sheemia/STC89C52RC-AutoCar/Document/Gerber_PCB1_2025-12-20_仿真图_(顶层).png

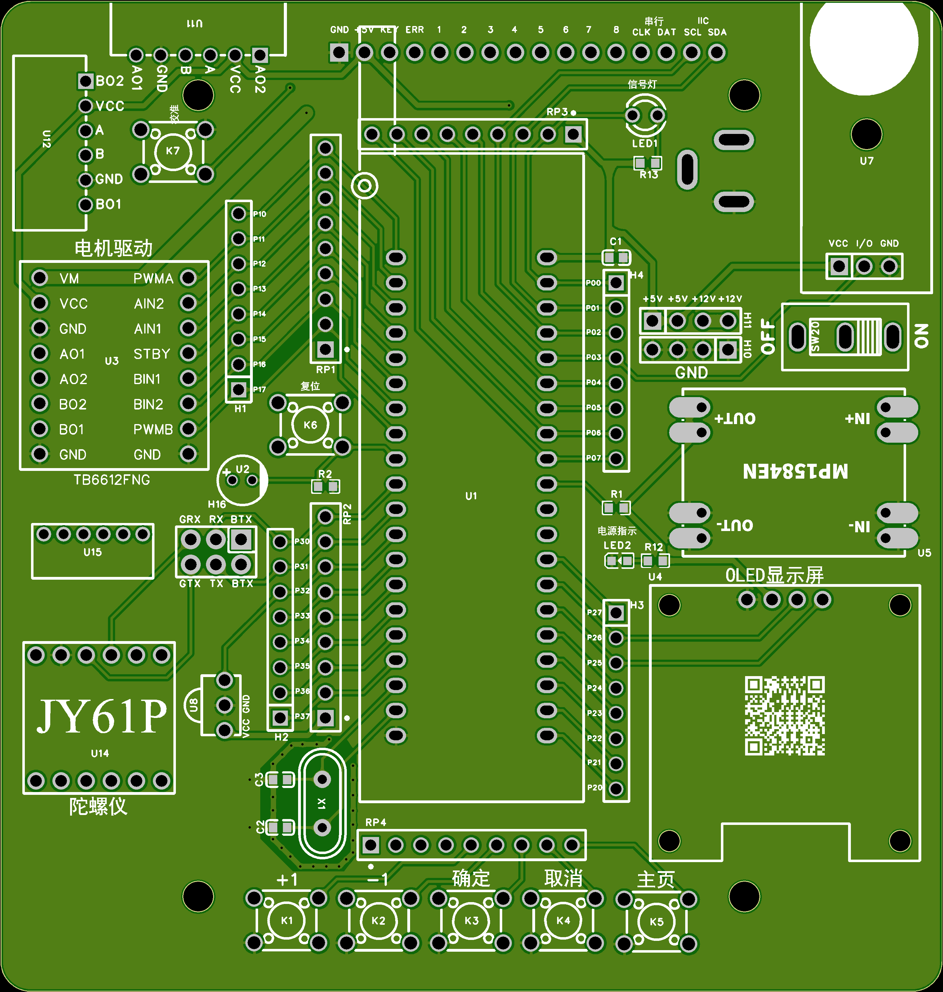
Document/Gerber_PCB1_2025-12-20_仿真图_(顶层).png
