sheemia/STC89C52RC-AutoCar/(list of files, cad)

Other CAD files:
Objects/main.obj
Objects/oled.obj
Objects/Task6.obj
Objects/Delay.obj
Objects/Key.obj
Objects/Motor_PID.obj
Objects/I2C.obj
Objects/Task5.obj
Objects/OledDisplay_Home.obj
Objects/UART_JY61P.obj
Objects/MatrixKey.obj
Objects/Task7.obj
Objects/Task2.obj
Objects/LCD1602.obj
Objects/Task3.obj
Objects/Home.obj
Objects/Task4.obj
Objects/GrayscaleSensor.obj
Objects/Timer1.obj
Objects/Motor.obj
Objects/DigitalTube.obj
Objects/Driving.obj
Objects/OledDisplay.obj
Objects/Timer2.obj
Objects/Timer0.obj
Objects/Menu.obj
Objects/Mpu6050.obj
Objects/Gyro_PID.obj
Objects/AT24C02.obj
Objects/Task1.obj
