sheemia/STC89C52RC-AutoCar/Document/SCH_Schematic1_2025-12-26.pdf

21 21 20 20 19 19 18 18 17 17 16 16 15 15 14 14 13 13 12 12 11 11 10 10 9

# 供电模块

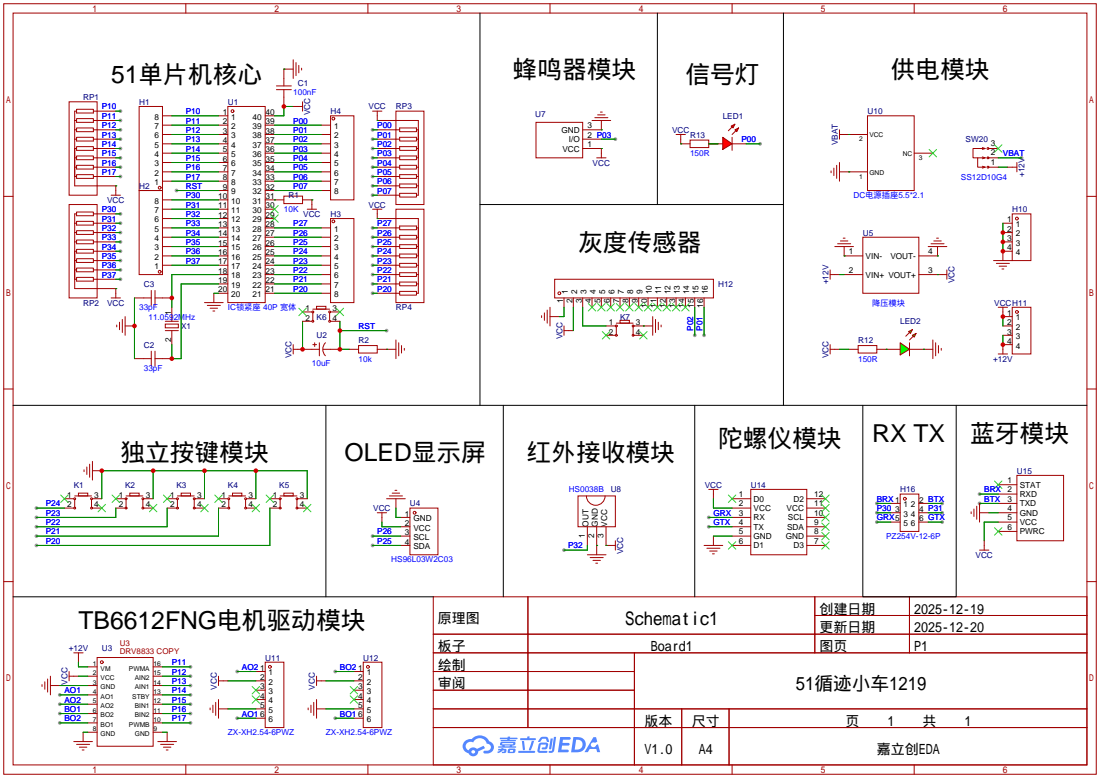
[picture p17: page 1]

更新日期 | 2025-12-20

板子 | Board1 | 图页 | P1
绘制 | | 51循迹小车1219
审阅

V1.0 | A4 | 嘉立创EDA
