sheemia/STC89C52RC-AutoCar/Document/PCB_PCB1_2025-12-26.pdf

BO1

## GND

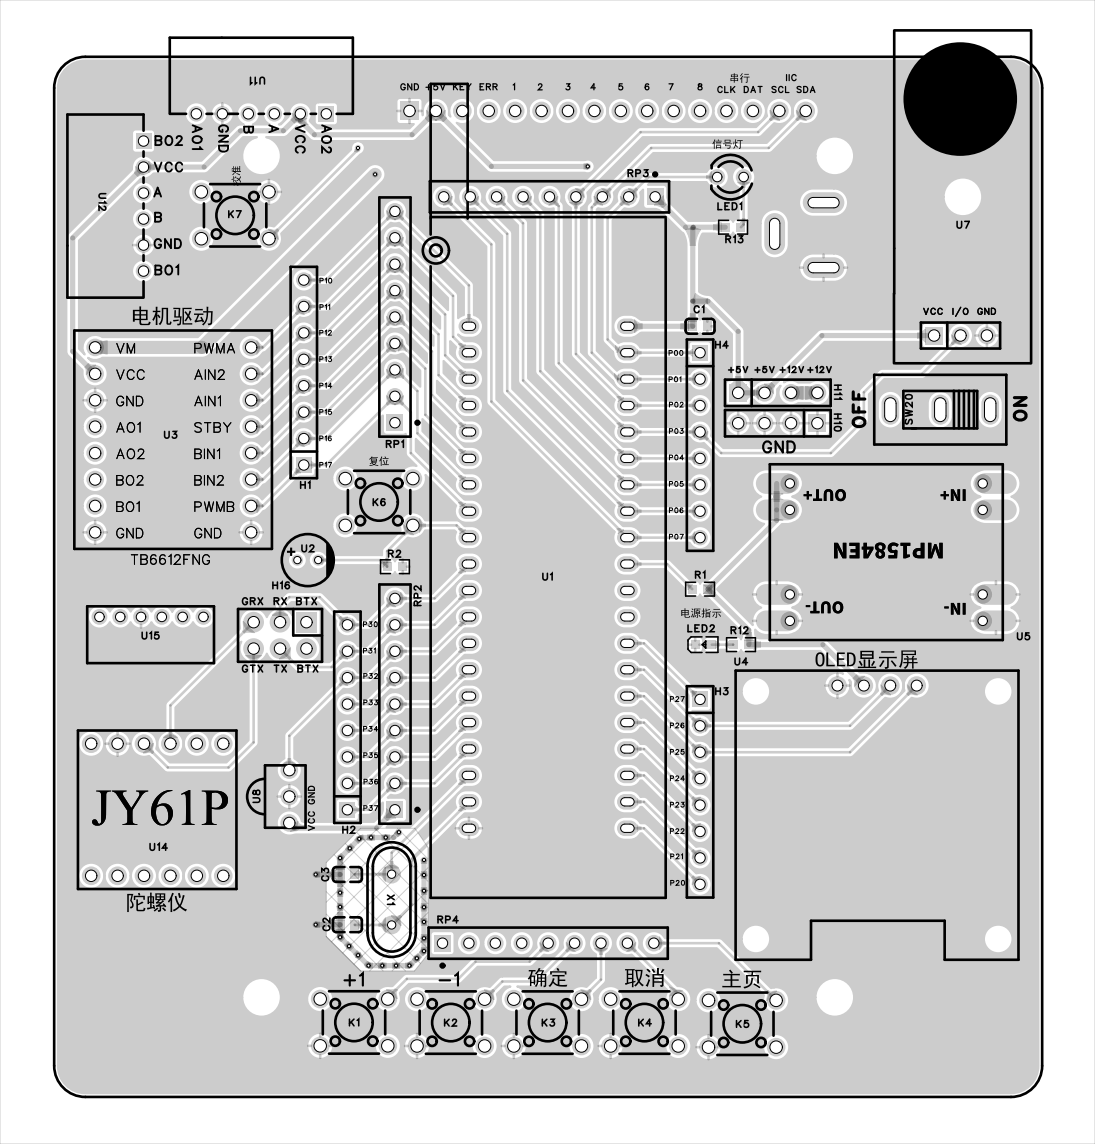
[picture p18: page 1]

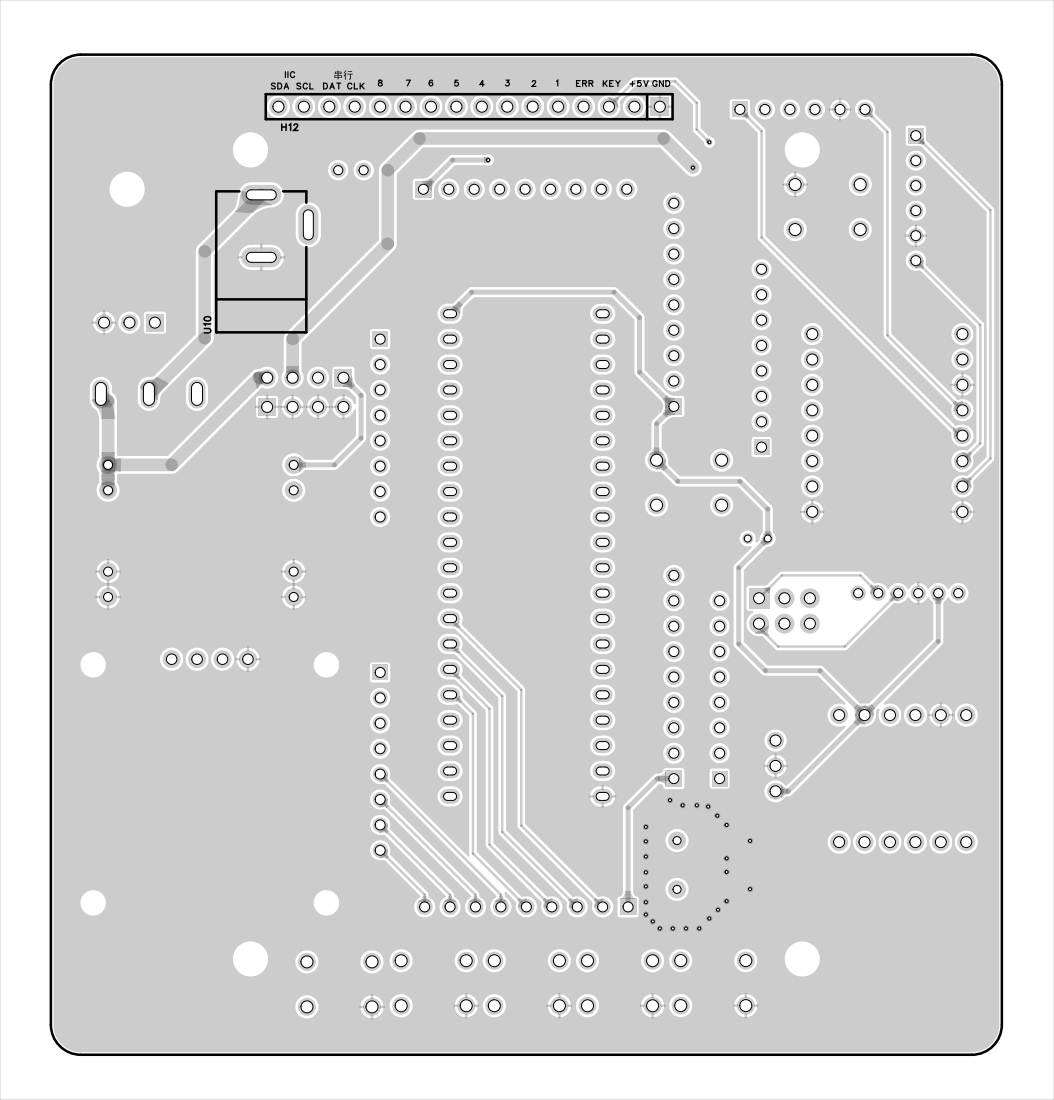
[picture p19: page 2]

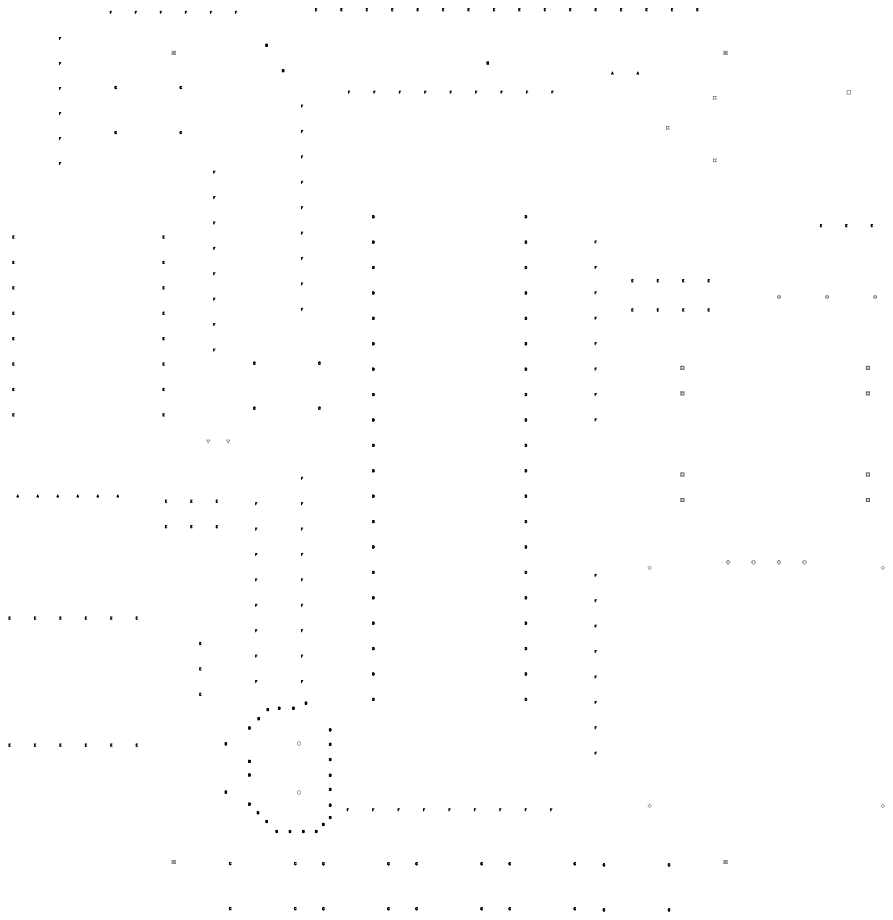
[picture p20: page 3]
