sheemia/STC89C52RC-AutoCar/Driving.h

#ifndef __Driving_H__
#define __Driving_H__

void Motor_Set(char sL, char sR);
unsigned char All_Black_Flag();
unsigned char All_White_Flag();
void Forward_ABit();
void AV_Prompt();
void UTurn();
void Turn_Left_90();
void Turn_Right_90();
void Turn_0();
void Turn_180();

#endif
