sheemia/STC89C52RC-AutoCar/Task3.c

#include <REGX52.H>
#include "oled.h"
#include "Key.h"
#include "Motor.h"
#include "Delay.h"
#include "Motor_PID.h"
#include "Gyro_PID.h"
#include "GrayscaleSensor.h"
#include "Driving.h"

unsigned char Task3_KeyNumber;

unsigned char Task3()
{
	last_error = 0;
	Base_Speed=20;
	
	OLED_Clear();
	OLED_ShowString(44,0,"Task3",16);
	OLED_ShowString(36,3,"Running",16);
	Motor_Init();
	
	Motor_Set(Base_Speed,Base_Speed);
	
	while(1)
	{
		Task3_KeyNumber=Key();
		if(Task3_KeyNumber)
		{
			switch(Task3_KeyNumber)
			{
				case 4:Motor_Set(0,0);return 1;break;
				case 5:Motor_Set(0,0);return 0;break;
			}
		}
		
		PID_Control_Loop();
		
		if (All_Black_Flag())
		{
			AV_Prompt();
			Forward_ABit();
			Base_Speed=12;
			
			PID_Control_Loop();
			
			while(!All_Black_Flag())
			{
				PID_Control_Loop();
			}
			
			AV_Prompt();
			
			while(1)
			{
				Task3_KeyNumber=Key();
				if(Task3_KeyNumber)
				{
					switch(Task3_KeyNumber)
					{
						case 4:Motor_Set(0,0);return 1;break;
						case 5:Motor_Set(0,0);return 0;break;
					}
				}
			}
			
		}
		
	}
}
		
