sheemia/STC89C52RC-AutoCar/Task.h

#ifndef __TASK_H__
#define __TASK_H__

unsigned char Task1();
unsigned char Task2();
unsigned char Task3();
unsigned char Task4();
unsigned char Task5();
unsigned char Task6();
unsigned char Task7();

#endif
