sheemia/STC89C52RC-AutoCar/(notices)

Notices in the files:
README.md:
License: MIT
